TiaTaiT/GSM_Alarm_Transmitter/GSMtransmitter.kicad_pcb

## KiCad design GSMtransmitter.kicad_pcb (2026-11-10)

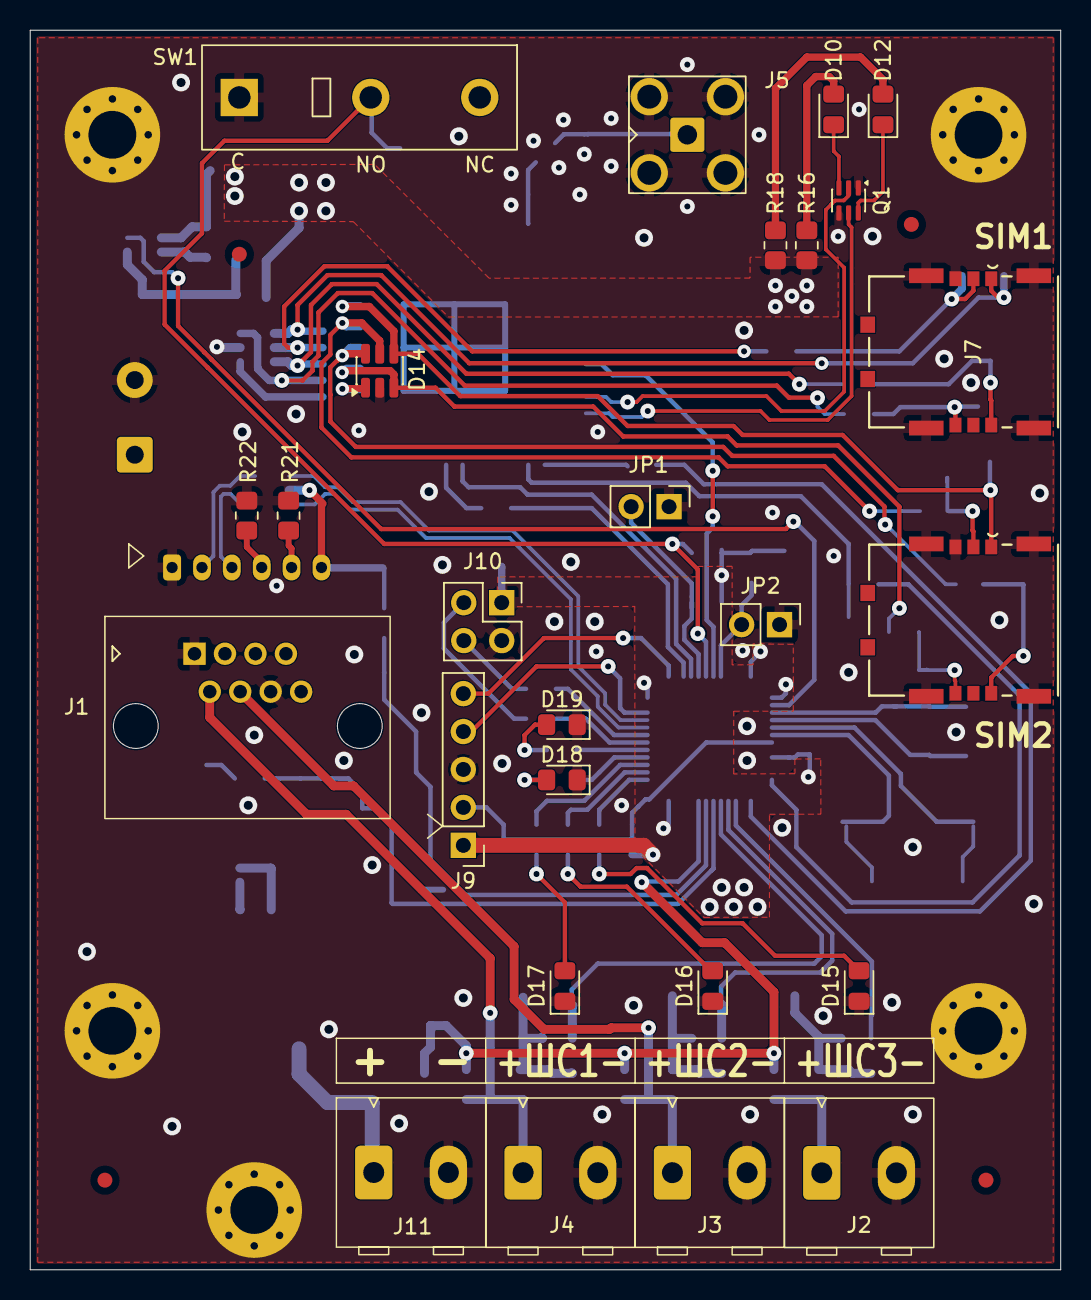
[picture p1: board GSMtransmitter.kicad_pcb from above]

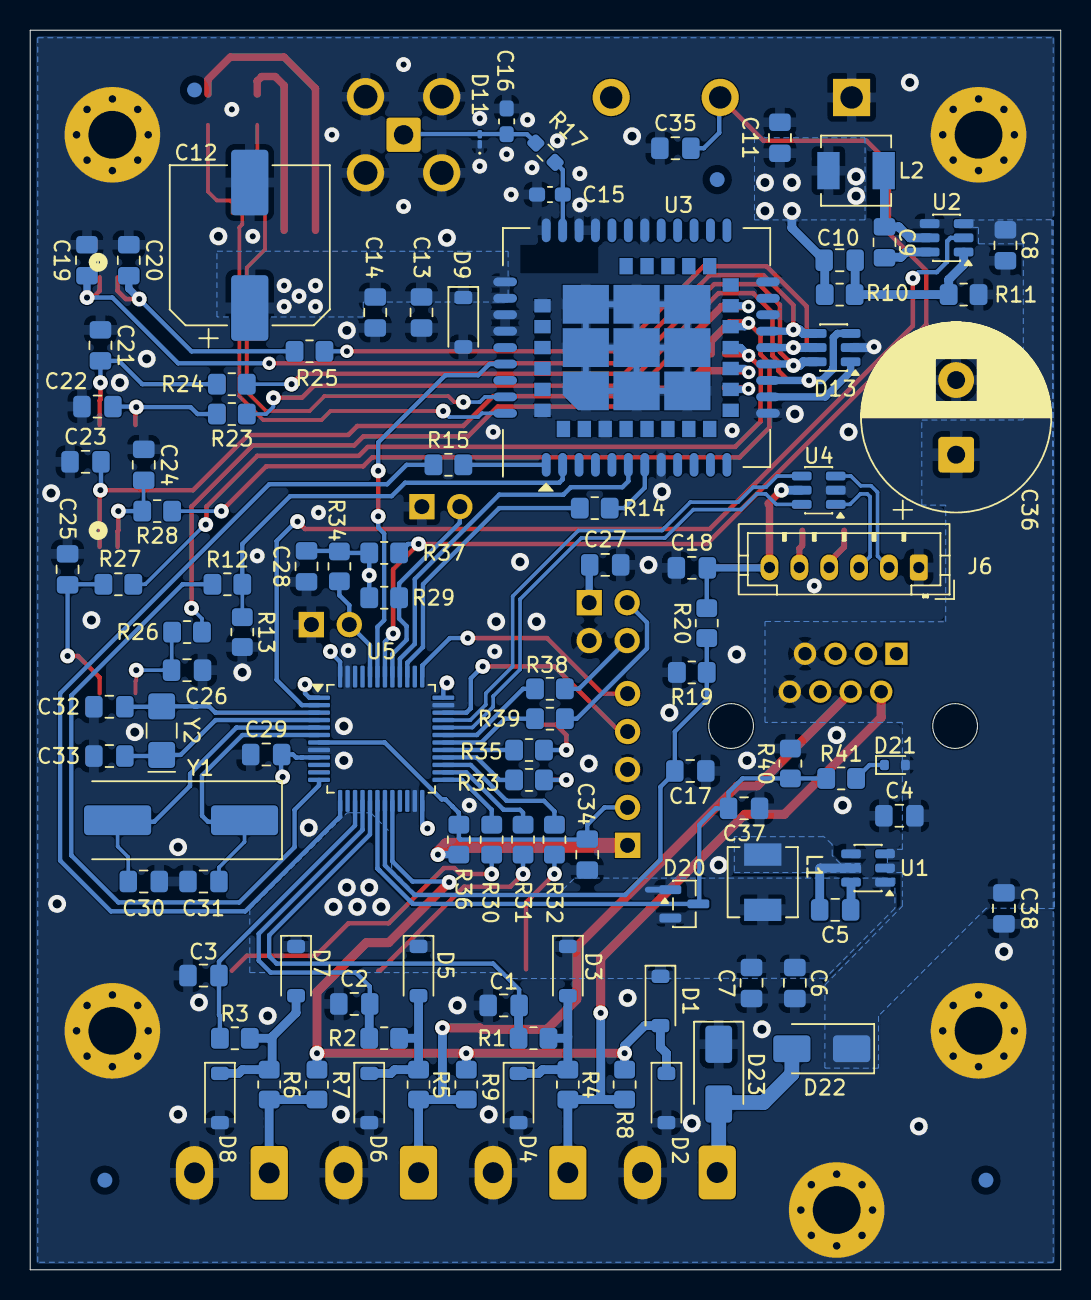
[picture p2: board GSMtransmitter.kicad_pcb from below]

Board: 2 copper layers, 69.0 x 83.0 mm, 139 parts (104 on the bottom side), 87 nets.

Parts:
C1, C2, C3, C5, C9, C11, C17, C18, C19, C23, C27, C28, C29, C34, C35, C37: 100nF; C_0805_2012Metric_Pad1.18x1.45mm_HandSolder
C4, C8: 10uF; C_0805_2012Metric_Pad1.18x1.45mm_HandSolder
C6, C7: 22uF; C_0805_2012Metric_Pad1.18x1.45mm_HandSolder
C10: 100pF; C_0805_2012Metric_Pad1.18x1.45mm_HandSolder
C12: 1000uF x 10V; CP_Elec_10x10.5
C13: 10pF; C_0805_2012Metric_Pad1.18x1.45mm_HandSolder
C14: 33pF; C_0805_2012Metric_Pad1.18x1.45mm_HandSolder
C15, C16: 10pF; C_0603_1608Metric_Pad1.08x0.95mm_HandSolder
C20, C21, C22, C24, C25, C26: 22pF; C_0805_2012Metric_Pad1.18x1.45mm_HandSolder
C30, C31: 16pF; C_0805_2012Metric_Pad1.18x1.45mm_HandSolder
C32, C33: 12.5pF; C_0805_2012Metric_Pad1.18x1.45mm_HandSolder
C36: 1000uFx35V; CP_Radial_D12.5mm_P5.00mm
C38: 470nFx50V; C_0805_2012Metric_Pad1.18x1.45mm_HandSolder
D1, D2, D3, D4, D5, D6, D7, D8: MBR0580; D_SOD-123
D9: MMSZ5231BT1G; D_SOD-123
D10: STATUS; LED_0805_2012Metric_Pad1.15x1.40mm_HandSolder
D11: LXES1UTAA1-157; D_01005_0402Metric_Pad0.57x0.30mm_HandSolder
D12: NETLIGHT; LED_0805_2012Metric_Pad1.15x1.40mm_HandSolder
D13, D14: ESDA6V1-5SC6; SOT-23-6
D15, D16, D17, D18: FYLS-0805GC; LED_0805_2012Metric_Pad1.15x1.40mm_HandSolder
D19: FYLS-0805SRC; LED_0805_2012Metric_Pad1.15x1.40mm_HandSolder
D20: BAS40-04; SOT-23
D21: 1N4148WT; D_SOD-523
D22: SS26; D_SMA
D23: SMAJ30CA; D_SMA
FID1, FID2, FID3, FID4, FID5, FID6, FID7, FID8: Fiducial; Fiducial_1mm_Mask2mm
H1, H2, H3, H4, H5: MountingHole_Pad; MountingHole_3.2mm_M3_Pad_Via
J1: DS1134-S80BPX; RJ45_DS1134-8P8CX_Horizontal
J2, J3, J4: Conn_DEGSON_01x02_Pin; DEGSON_DG390-5.0-02P_1x02_P5.0mm_Vertical
J5: RF Antenna; SMA_HJ-SMA405
J6: USB-C; JST_PH_B6B-PH-K_1x06_P2.00mm_Vertical
J7, J8: 1042240820; 1042240820_MOLEX
J9: SWD; PinHeader_1x05_P2.54mm_Vertical
J10: UART1; PinSocket_2x02_P2.54mm_Vertical
J11: DG390-5.0-02P; DEGSON_DG390-5.0-02P_1x02_P5.0mm_Vertical
JP1, JP2: Jumper_2_Open; PinHeader_1x02_P2.54mm_Vertical
L1: CSAB0420-3R3M; CSAB0420-4.4x4.4mm
L2: CSAB0420-100M; CSAB0420-4.4x4.4mm
Q1: MUN5233DW1; SOT-363_SC-70-6
R1, R2, R3: 150k; R_0805_2012Metric_Pad1.20x1.40mm_HandSolder
R4, R5, R6: 4k7; R_0805_2012Metric_Pad1.20x1.40mm_HandSolder
R7, R8, R9: 10k; R_0805_2012Metric_Pad1.20x1.40mm_HandSolder
R10: 205k; R_0805_2012Metric_Pad1.20x1.40mm_HandSolder
R11: 51k; R_0805_2012Metric_Pad1.20x1.40mm_HandSolder
R12, R14, R15: 1k; R_0805_2012Metric_Pad1.20x1.40mm_HandSolder
R13: 5.6k; R_0805_2012Metric_Pad1.20x1.40mm_HandSolder
R16, R18: 470; R_0805_2012Metric_Pad1.20x1.40mm_HandSolder
R17: 0; R_0603_1608Metric_Pad0.98x0.95mm_HandSolder
R19: 47k; R_0805_2012Metric_Pad1.20x1.40mm_HandSolder
R20, R29, R34, R36, R37, R40: 100k; R_0805_2012Metric_Pad1.20x1.40mm_HandSolder
R21, R22: 5.1k; R_0805_2012Metric_Pad1.20x1.40mm_HandSolder
R23, R24, R25, R26, R27, R28, R38, R39: 51; R_0805_2012Metric_Pad1.20x1.40mm_HandSolder
R30, R31, R32, R33: 330; R_0805_2012Metric_Pad1.20x1.40mm_HandSolder
R35: 510; R_0805_2012Metric_Pad1.20x1.40mm_HandSolder
R41: 1M; R_0805_2012Metric_Pad1.20x1.40mm_HandSolder
SW1: SM5-180UP-1; SW_XKB_SM5-180UP-1
U1: AP63203WU; TSOT-23-6
U2: AP63200WU; TSOT-23-6
U3: SIM800C-DS; SIMCom_SIM800C-DS
U4: USBLC6-2SC6; SOT-23-6
U5: STM32L072CBT6; LQFP-48_7x7mm_P0.5mm
Y1: 4 MHz; Crystal_SMD_HC49-SD
Y2: 32768 kHz; Crystal_SMD_EuroQuartz_EQ161-2Pin_3.2x1.5mm_HandSoldering

Connections:
+3V3: C6.2, C7.2, C27.2, C28.2, C29.2, D1.1 (K), D3.1 (K), D5.1 (K), D7.1 (K), D20.2, J9.1, J10.1, L1.2, R29.1, R34.1, R36.1, R37.1, U1.1 (FB), U5.1 (VDD), U5.9 (VDDA), U5.24 (VDD), U5.36 (VDD_USB), U5.48 (VDD)
+4V: C10.2, C11.2, C12.1, C13.2, C14.2, D9.1 (K), L2.2, R10.2, R16.1, R18.1, U3.34 (VBAT), U3.35 (VBAT)
/4V_ENABLE: U2.2 (EN), U5.2 (PC13)
/ALARM_IN1: C1.2, R1.1, U5.17 (PA7)
/ALARM_IN2: C2.2, R2.1, U5.16 (PA6)
/ALARM_IN3: C3.2, R3.1, U5.15 (PA5)
/ALARM_PULLUP: D1.2 (A), D2.1 (K), R7.2, R8.1, R9.1, U5.20 (PB2)
/BATTERY_LEVEL: C37.2, D20.3, R40.1, R41.1, U5.18 (PB0)
/IN_OUT/D1SENSE: J1.2, J4.1, R4.2, R8.2
/IN_OUT/D2SENSE: J1.4, J3.1, R5.2, R9.2
/IN_OUT/D3SENSE: J2.1, R6.2, R7.1
/IN_OUT/VBAT_IN: C4.2, C8.2, C36.1, C38.1, D21.2 (A), D22.1 (K), J1.7, J1.8, U1.2 (EN), U1.3 (IN), U2.3 (IN)
/MCU/BOOT0: JP2.2 (B), R34.2, U5.44 (BOOT0)
/MCU/LED1: R30.1, U5.25 (PB12)
/MCU/LED2: R31.1, U5.26 (PB13)
/MCU/LED3: R32.1, U5.27 (PB14)
/MCU/LED4: R33.1, U5.28 (PB15)
/MCU/LED5: R35.1, U5.29 (PA8)
/MCU/NRST: C34.1, J9.2, R36.2, U5.7 (NRST)
/MCU/SWCLK: J9.5, U5.37 (PA14)
/MCU/SWDIO: J9.4, U5.34 (PA13)
/MCU/TAMPER: C35.2, R37.2, SW1.2 (B), U5.42 (PB6)
/MCU/UART1_RX: J10.4, R38.2
/MCU/UART1_TX: J10.2, R39.2
/MCU/USB_D+: U4.4 (I/O2), U5.33 (PA12)
/MCU/USB_D-: U4.6 (I/O1), U5.32 (PA11)
/MCU/VBUS_SENSING: C17.2, R19.1, R20.1, U5.19 (PB1)
/Power_3.3V (page 3)/3V3-BST: C5.1, U1.6 (BST)
/Power_3.3V (page 3)/3V3-SW: C5.2, L1.1, U1.5 (SW)
/Power_4V/4V-FB: C10.1, R10.1, R11.2, U2.1 (FB)
/Power_4V/4V-SW: C9.2, L2.1, U2.5 (SW)
/Power_input/Vsupply: D22.2 (A), D23.2 (A2), J11.1
/RF_ENABLE: U3.39 (~PWRKEY), U5.43 (PB7)
/RFmodule/NETLIGHT: Q1.2 (B), U3.41 (NETLIGHT)
/RFmodule/SIM1_CLK: D13.6 (IO5), R24.1, U3.16 (SIM1_CLK)
/RFmodule/SIM1_DATA: D13.3 (IO2), R23.1, U3.15 (SIM1_DATA)
/RFmodule/SIM1_DET: D13.1 (IO1), U3.14 (SIM1_DET)
/RFmodule/SIM1_RST: D13.5 (IO4), R25.1, U3.17 (SIM1_RST)
/RFmodule/SIM1_VDD: C19.2, D13.4 (IO3), J7.S1 (VCC), U3.18 (SIM1_VDD)
/RFmodule/SIM2_CLK: D14.6 (IO5), R27.1, U3.54 (SIM2_CLK)
/RFmodule/SIM2_DATA: D14.3 (IO2), R26.1, U3.53 (SIM2_DATA)
/RFmodule/SIM2_DET: D14.1 (IO1), U3.52 (SIM2_DET)
/RFmodule/SIM2_RST: D14.5 (IO4), R28.1, U3.55 (SIM2_RST)
/RFmodule/SIM2_VDD: C23.2, D14.4 (IO3), J8.S1 (VCC), U3.56 (SIM2_VDD)
/RFmodule/STATUS: Q1.5 (B), U3.42 (STATUS)
/SIMcard1/CARD_CLK: C21.2, J7.S3 (CLK), R24.2
/SIMcard1/CARD_DATA: C22.2, J7.S6 (I/O), R23.2
/SIMcard1/CARD_RST: C20.2, J7.S2 (RST), R25.2
/SIMcard2/CARD_CLK: C25.2, J8.S3 (CLK), R27.2
/SIMcard2/CARD_DATA: C26.2, J8.S6 (I/O), R26.2
/SIMcard2/CARD_RST: C24.2, J8.S2 (RST), R28.2
/UART2_DTR: U3.6 (UART1_DTR), U5.40 (PB4)
/UART2_RI: R14.1, U5.39 (PB3)
/UART2_RX: R15.1, U5.13 (PA3)
/UART2_TX: R12.1, U5.12 (PA2)
/USB/USB_CC1: J6.5, R21.1
/USB/USB_CC2: J6.4, R22.1
/USB/USB_N: J6.3, U4.1 (I/O1)
/USB/USB_P: J6.2, U4.3 (I/O2)
/USB/USB_VBUS: C18.2, J6.6, R20.2, U4.5 (VBUS)
GNDD: C1.1, C2.1, C3.1, C4.1, C6.1, C7.1, C8.1, C11.1, C12.2, C13.1, C14.1, C15.1, C16.1, C17.1, C18.1, C19.1, C20.1, C21.1, C22.1, C23.1, C24.1, C25.1, C26.1, C27.1, C28.1, C29.1, C30.1, C31.1, C32.1, C33.1, C34.2, C35.1, C36.2, C37.1, C38.2, D2.2 (A), D4.2 (A), D6.2 (A), D8.2 (A), D9.2 (A), D11.1 (A1), D13.2 (GND), D14.2 (GND), D15.1 (K), D16.1 (K), D17.1 (K), D18.1 (K), D19.1 (K), D20.1, D23.1 (A1), H1.1 (1_1), H2.1 (1_1), H3.1 (1_1), H4.1 (1_1), H5.1 (1_1), J1.1, J1.6, J2.2, J3.2, J4.2, J5.2 (Ext), J6.1, J7.G (SH), J7.S4 (GND), J8.G (SH), J8.S4 (GND), J9.3, J10.3, J11.2, JP1.1 (A), JP2.1 (A), Q1.1 (E), Q1.4 (E), R11.1, R13.1, R19.2, R21.2, R22.2, R40.2, SW1.1 (A), U1.4 (GND), U2.4 (GND), U3.8 (GND), U3.13 (GND), U3.19 (GND), U3.21 (GND), U3.27 (GND), U3.30 (GND), U3.31 (GND), U3.33 (GND), U3.36 (GND), U3.37 (GND), U3.45 (GND), U3.63 (GND), U3.66 (GND), U3.68 (GND), U3.69 (GND), U3.70 (GND), U3.71 (GND), U3.72 (GND), U3.73 (GND), U3.74 (GND), U3.75 (GND), U3.76 (GND), U3.77 (GND), U4.2 (GND), U5.8 (VSSA), U5.23 (VSS), U5.35 (VSS), U5.47 (VSS)
unnamed: D3.2 (A), D4.1 (K), R1.2, R4.1
unnamed: D5.2 (A), D6.1 (K), R2.2, R5.1
unnamed: D7.2 (A), D8.1 (K), R3.2, R6.1
unnamed: D10.2 (A), R16.2
unnamed: D10.1 (K), Q1.3 (C)
unnamed: C16.2, D11.2 (A2), J5.1 (In), R17.2
unnamed: D12.2 (A), R18.2
unnamed: D12.1 (K), Q1.6 (C)
unnamed: D15.2 (A), R30.2
unnamed: D16.2 (A), R31.2
unnamed: D17.2 (A), R32.2
unnamed: D18.2 (A), R33.2
unnamed: D19.2 (A), R35.2
unnamed: D21.1 (K), R41.2
unnamed: JP1.2 (B), R29.2, U5.41 (PB5)
unnamed: C9.1, U2.6 (BST)
unnamed: C15.2, R17.1, U3.32 (GSM_ANT)
unnamed: R14.2, U3.7 (UART1_RI)
unnamed: R12.2, R13.2, U3.2 (UART1_RXD)
unnamed: R15.2, U3.1 (UART1_TXD)
unnamed: R39.1, U5.30 (PA9)
unnamed: R38.1, U5.31 (PA10)
unnamed: C32.2, U5.3 (PC14), Y2.2
unnamed: C33.2, U5.4 (PC15), Y2.1
unnamed: C30.2, U5.5 (PH0), Y1.2
unnamed: C31.2, U5.6 (PH1), Y1.1
