TiaTaiT/GSM_Alarm_Transmitter/(commit log)

2025-03-21 STM32L052 instead STM32L051
    [GSMtransmitter.kicad_pcb, GSMtransmitter.kicad_sch]
2025-03-21 Wrong 32kHz clock pins fixed
    [GSMtransmitter.kicad_pcb, GSMtransmitter.kicad_sch]
2025-03-24 32kHz replaced
    [GSMtransmitter.kicad_pcb, GSMtransmitter.kicad_sch, IN_OUT.kicad_sch, PowerSupply.kicad_sch, Power_4V.kicad_sch, rf_module.kicad_sch]
2025-03-28 Inductance was replaced
    [GSMtransmitter.kicad_pcb, GSMtransmitter.kicad_sch, PowerSupply.kicad_sch, rf_module.kicad_sch]
2025-04-16 USB pinout fixed
    [GSMtransmitter.kicad_pcb, GSMtransmitter.kicad_sch]
2025-07-29 Minor changes in PCB for manufacturing
    [GSMtransmitter.kicad_pcb]
2025-11-07 DEGSON f.mask pad fixed
    [GSMtransmitter.kicad_pcb]
2026-07-10 Dual SIM version
    [GSMtransmitter.kicad_pcb, GSMtransmitter.kicad_sch, IN_OUT.kicad_sch, MCU.kicad_sch, PowerSupply.kicad_sch, Power_input.kicad_sch, SIMcard.kicad_sch, USB.kicad_sch]
2026-08-05 Silk layers minor fixes
    [GSMtransmitter.kicad_pcb]
2026-11-10 USB connector reverse
